SmartLogicUA/PRW-125-26/images/RFID_PRW_125_26_1.jpg

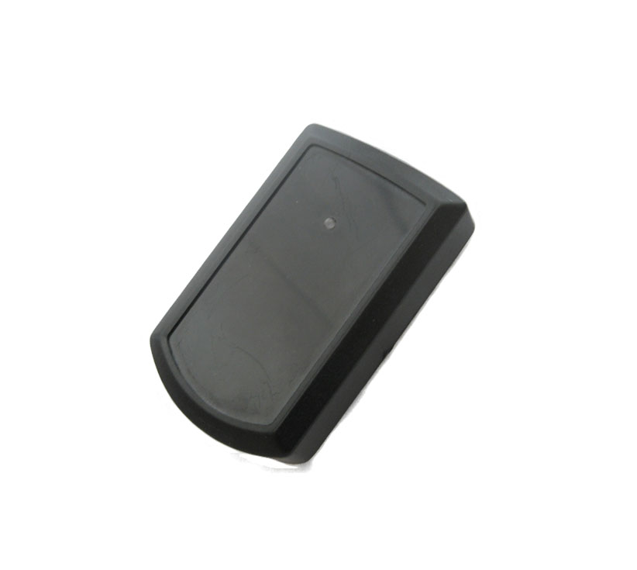
images/RFID_PRW_125_26_1.jpg
