SmartLogicUA/PRW-125-26/(list of files, drawings)

Other design files:
scheme/v9.3.X/PCAD/V 9.3.X.pcb
scheme/v9.3.X/PIC/SIDE.pcb
scheme/v9.3.X/PIC/TOP.pcb
