SmartLogicUA/PRW-125-26/(commit log)

2017-01-08 Added the source code of reader, bootloader and schematic
    [Raschet_V9.3.X.xls, SIDE.pcb, TOP.pcb, V 9.3.X.pcb, V 9.3.X.sch]
2017-01-08 Added documentation
    [Raschet_V9.3.X.xls]
